WillHovel/sensorized/flex_v2.kicad_pcb

## KiCad design flex_v2.kicad_pcb (2026-05-04)

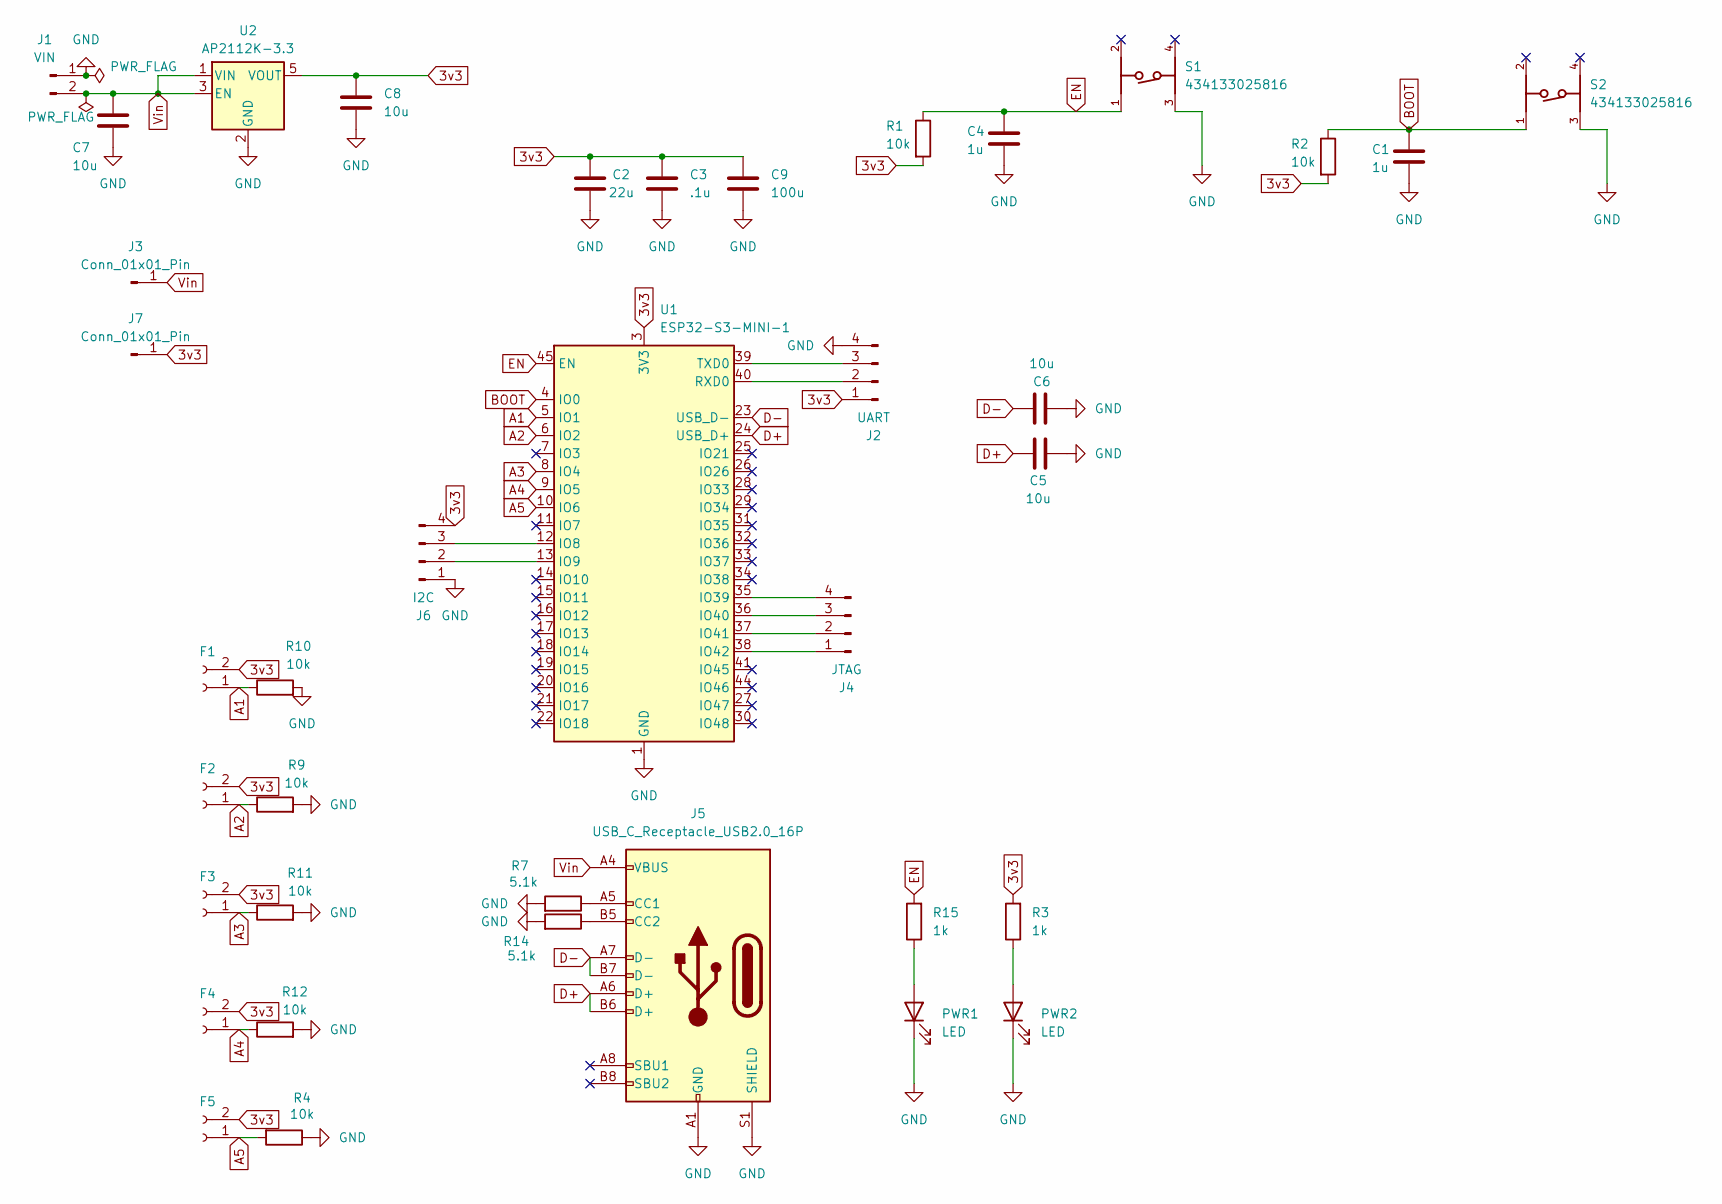
[picture p1: schematic flex_v2.kicad_sch]

Parts:
C1, C4: 1u; C_0603_1608Metric_Pad1.08x0.95mm_HandSolder
C2: 22u; C_0603_1608Metric_Pad1.08x0.95mm_HandSolder
C3: .1u; C_0603_1608Metric_Pad1.08x0.95mm_HandSolder
C5, C6, C7, C8: 10u; C_0603_1608Metric_Pad1.08x0.95mm_HandSolder
C9: 100u; C_0603_1608Metric_Pad1.08x0.95mm_HandSolder
F1, F2, F3, F4, F5: Conn_01x02_Socket; PinSocket_1x02_P2.54mm_Vertical
J1: VIN; PinHeader_1x02_P2.54mm_Vertical
J2: UART; PinHeader_1x04_P2.54mm_Vertical
J3, J7: Conn_01x01_Pin; PinHeader_1x01_P2.54mm_Vertical
J4: JTAG; PinHeader_1x04_P2.54mm_Vertical
J5: USB_C_Receptacle_USB2.0_16P; USB_C_Receptacle_GCT_USB4105-xx-A_16P_TopMnt_Horizontal
J6: I2C; PinHeader_1x04_P2.54mm_Vertical
PWR1, PWR2: LED; LED_0805_2012Metric_Pad1.15x1.40mm_HandSolder
R1, R2, R4, R9, R10, R11, R12: 10k; R_0603_1608Metric_Pad0.98x0.95mm_HandSolder
R3, R15: 1k; R_0603_1608Metric_Pad0.98x0.95mm_HandSolder
R7, R14: 5.1k; R_0603_1608Metric_Pad0.98x0.95mm_HandSolder
S1, S2: 434133025816
U1: ESP32-S3-MINI-1; ESP32-S2-MINI-1
U2: AP2112K-3.3; SOT-23-5

Connections:
3v3: C2.1, C3.1, C8.1, C9.1, F1.2, F2.2, F3.2, F4.2, F5.2, J2.1, J6.4, J7.1, R1.2, R2.2, R3.2, U1.3 (3V3), U2.5 (VOUT)
A1: F1.1, R10.1, U1.5 (IO1)
A2: F2.1, R9.1, U1.6 (IO2)
A3: F3.1, R11.1, U1.8 (IO4)
A4: F4.1, R12.1, U1.9 (IO5)
A5: F5.1, R4.2, U1.10 (IO6)
BOOT: C1.2, R2.1, S2.1, U1.4 (IO0)
D+: C5.1, J5.A6 (D+), J5.B6 (D+), U1.24 (USB_D+)
D-: C6.2, J5.A7 (D-), J5.B7 (D-), U1.23 (USB_D-)
EN: C4.2, R1.1, R15.2, S1.1, U1.45 (EN)
GND: C1.1, C2.2, C3.2, C4.1, C5.2, C6.1, C7.2, C8.2, C9.2, J1.1, J2.4, J5.A1 (GND), J5.A12 (GND), J5.B1 (GND), J5.B12 (GND), J5.S1 (SHIELD), J6.1, PWR1.1 (K), PWR2.1 (K), R4.1, R7.2, R9.2, R10.2, R11.2, R12.2, R14.2, S1.3, S2.3, U1.1 (GND), U1.2 (GND), U1.42 (GND), U1.43 (GND), U1.46 (GND), U1.47 (GND), U1.48 (GND), U1.49 (GND), U1.50 (GND), U1.51 (GND), U1.52 (GND), U1.53 (GND), U1.54 (GND), U1.55 (GND), U1.56 (GND), U1.57 (GND), U1.58 (GND), U1.59 (GND), U1.60 (GND), U1.61 (GND), U1.62 (GND), U1.63 (GND), U1.64 (GND), U1.65 (GND), U2.2 (GND)
unnamed: J2.2, U1.40 (RXD0)
unnamed: J2.3, U1.39 (TXD0)
unnamed: J4.1, U1.38 (IO42)
unnamed: J4.2, U1.37 (IO41)
unnamed: J4.3, U1.36 (IO40)
unnamed: J4.4, U1.35 (IO39)
unnamed: J5.A5 (CC1), R7.1
unnamed: J5.B5 (CC2), R14.1
unnamed: J6.2, U1.13 (IO9)
unnamed: J6.3, U1.12 (IO8)
unnamed: PWR1.2 (A), R15.1
unnamed: PWR2.2 (A), R3.1
Vin: C7.1, J1.2, J3.1, J5.A4 (VBUS), J5.A9 (VBUS), J5.B4 (VBUS), J5.B9 (VBUS), U2.1 (VIN), U2.3 (EN)

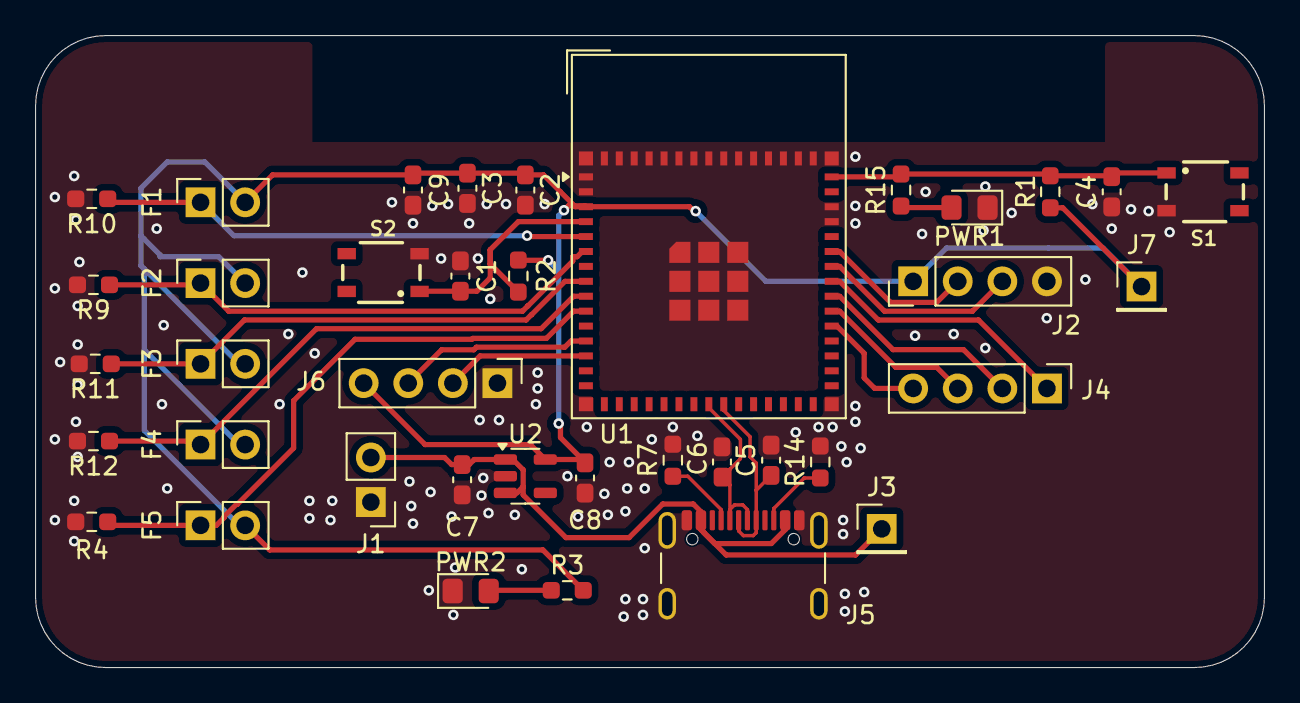
[picture p2: board flex_v2.kicad_pcb from above]

Board: 2 copper layers, 70.0 x 36.0 mm, 38 parts (0 on the bottom side), 24 nets.
