WillHovel/sensorized/esp32_gesture_recognition/GestureShared/src/gesture_config.h

#pragma once
#include <Arduino.h>

// ---------------------------------------------------------------------------
// Flex sensor wiring
// ---------------------------------------------------------------------------
// Each flex sensor forms a voltage divider with a fixed 10.0k ohm resistor
// (per the sensor's own datasheet, which pairs it with a 10k fixed resistor
// - the sensor sits at ~10k ohm itself at rest) between 3V3 and GND. The
// divider midpoint feeds one of the ADC pins below.
//
// GPIO1-GPIO5 are used because they are ADC1 channels (ADC1 stays usable
// even if you later add Wi-Fi/BLE, unlike ADC2) and are not strapping pins
// on the ESP32-S3, so they're safe to use freely.
static const int FLEX_PINS[] = {1, 2, 3, 4, 5}; // GPIO1..GPIO5 = ADC1_CH0..CH4
#define NUM_SENSORS (sizeof(FLEX_PINS) / sizeof(FLEX_PINS[0]))

// Raw ADC samples averaged per reading, to cut down noise.
#define ADC_OVERSAMPLE 8

// ---------------------------------------------------------------------------
// Gesture classes
// ---------------------------------------------------------------------------
// This list is only used by 01_data_collection.ino, as the menu of labels
// you can tag samples with while recording. It is NOT what inference.ino
// uses to decide class order/count at runtime - that comes from
// model_weights.h, generated by train_model.py from whatever label strings
// actually appear in your dataset. Keep this list in sync with your data so
// the data-collection menu stays useful, but the two are otherwise
// independent.
//
// To add a gesture: append its name here, collect data for it, then re-run
// train_model.py - the trained network's output layer resizes automatically.
static const char* const GESTURE_LABELS[] = {
    "fist",
    "knife_hand",
    "triton",
    "thumbs_up",
    "thumbs_middle",
    "thumbs_down",
    "middle_finger",
};
#define NUM_GESTURE_LABELS (sizeof(GESTURE_LABELS) / sizeof(GESTURE_LABELS[0]))

// ---------------------------------------------------------------------------
// Display (I2C)
// ---------------------------------------------------------------------------
// Adjust to match your board - check its pinout silkscreen/datasheet.
#define OLED_SDA_PIN 8
#define OLED_SCL_PIN 9

// ---------------------------------------------------------------------------
// Sampling
// ---------------------------------------------------------------------------
#define SAMPLE_RATE_HZ 50

// ---------------------------------------------------------------------------
// Future: MPU6050 (not wired in yet)
// ---------------------------------------------------------------------------
// When you add the IMU, it'll sit on the same I2C bus as the display
// (address 0x68, default AD0 low). NN_INPUT_SIZE in model_weights.h will
// need to grow from 5 to include however many IMU features you add, and
// data_collection.ino/inference.ino will need to read+print/feed those extra
// columns alongside the flex sensors. Nothing else in this file needs to
// change ahead of time for that.
